fkuhne/ardubot17/Pictures/Photo 25-03-17 10 34 49.jpg

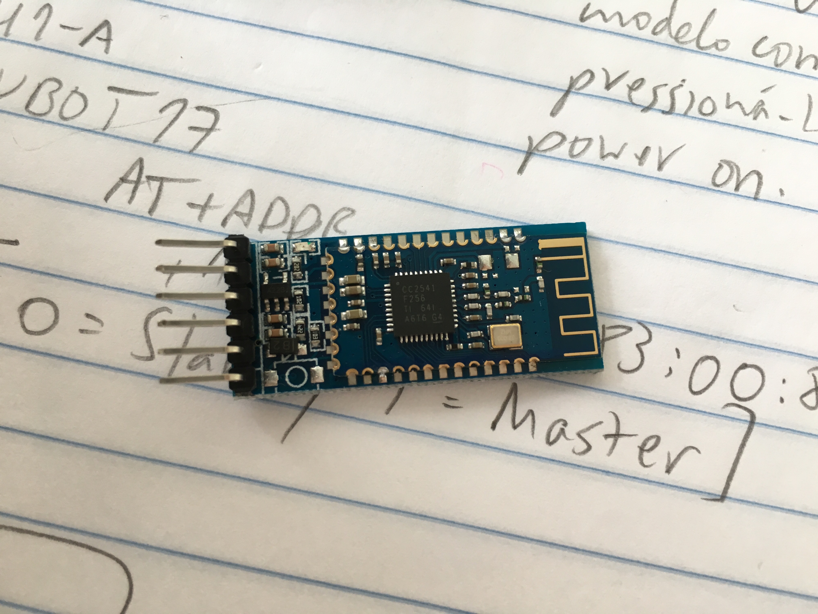
Pictures/Photo 25-03-17 10 34 49.jpg
