fkuhne/ardubot17/README.md

# ardubot17
Development for a remotely controlled toy car (almost a robot, but still not clever enough)
