fkuhne/ardubot17/Apresentação.pptx

## Veículo com controle remoto e Arduinos

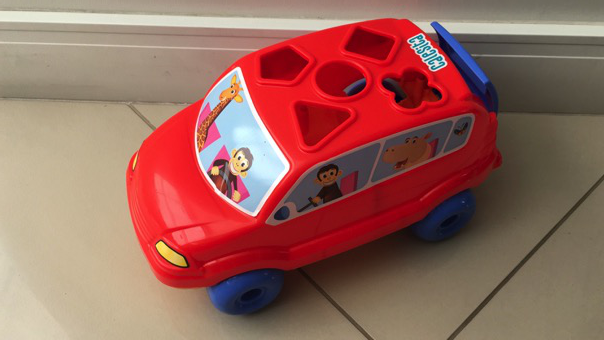
[picture p3: figure]

Felipe Kühne
fkuhne@gmail.com

## Slide 2

Felipe Kühne - fkuhne@gmail.com

github.com/fkuhne/ardubot17

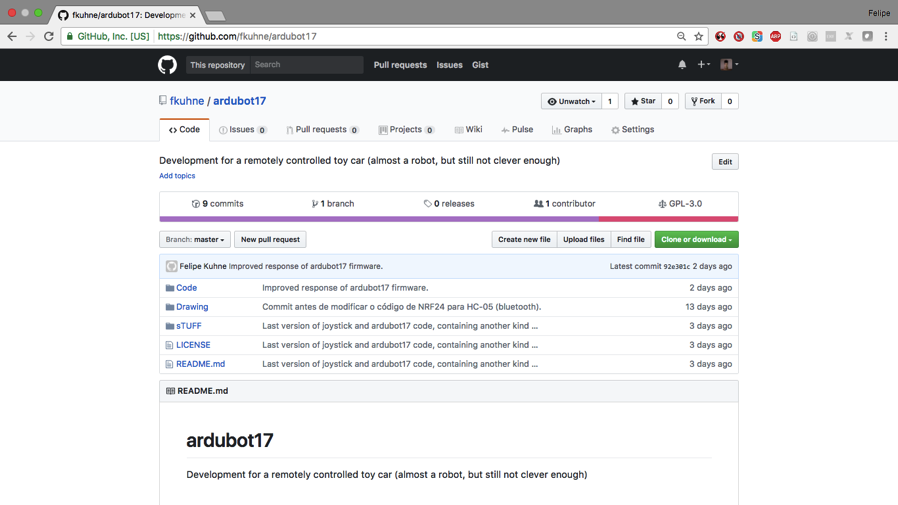
[picture p4: figure]

## Agenda

- Objetivos
- Recursos necessários
- Desenvolvimento
  - Mecânica
  - Eletrônica
  - Software
- O que deu errado (e depois deu certo)
- Trabalhos futuros

## Objetivos

Transformar um brinquedo em um robô móvel

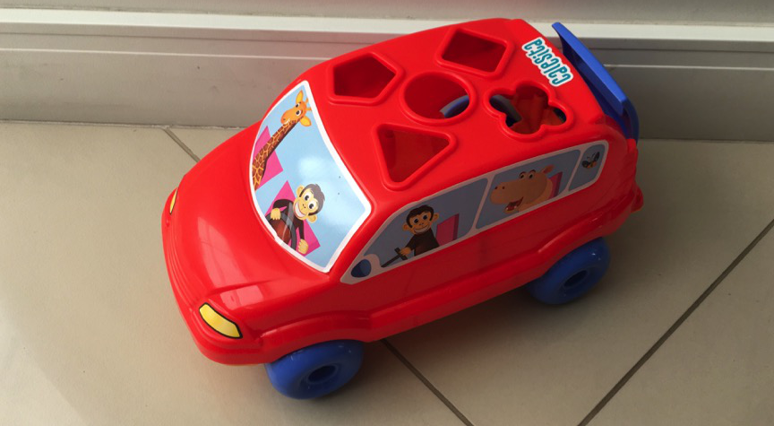
[picture p5: figure]

Não modificar aspectos externos do brinquedo

Ser barato

Poder voltar à sua forma original

Ter baixa complexidade

## Recursos necessários: veículo

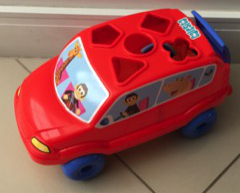
[picture p6: figure]

Carrinho
(R$30)

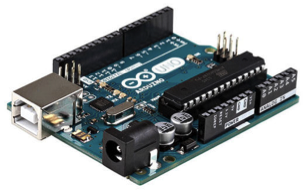
[picture p7: figure]

Arduino Uno
(R$5)

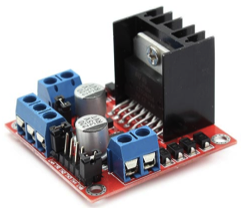
[picture p8: figure]

L298N
(R$6)

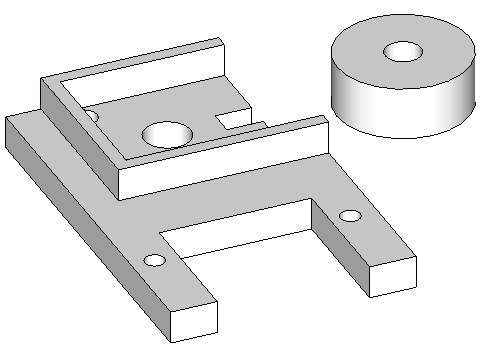
[picture p9: figure]

Suporte para o motor

Módulo Bluetooth
(R$11)

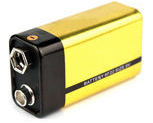
[picture p10: figure]

Bateria (R$20)

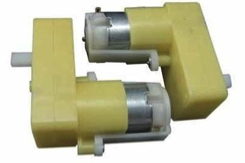
[picture p11: figure]

x2

Motor DC
(R$14)

## Recursos necessários: joystick

Arduino Uno
(R$5)

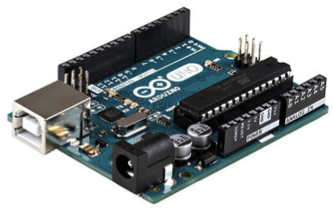
[picture p12: figure]

Protoshield
(R$4)

Módulo Bluetooth HC-05 (R$12)

Bateria (R$20)

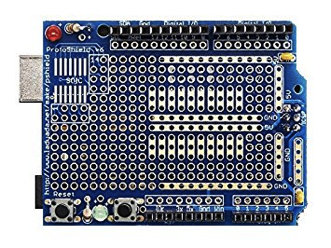
[picture p13: figure]
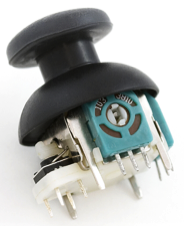
[picture p14: figure]

Joystick
(R$3)

## Recursos necessários: diversos

- Soldador e estanho
- Fitas dupla face
- Balão de festa
- Protoboard
- Parafuso auto-atarrachantes (x8)
- Chave SPST (x2)
- Cabinhos de protoboard (M/M, F/F, M/F)
- Resistores: 2x 1kΩ e 2x 2k2Ω
- Cabos USB
- Multímetro
- Paquímetro
- Ferramentas diversas (alicate, chave de fenda, fita isolante, ...)
- Computador
- Impressora 3D

## Recursos necessários: softwares

- Sketchup (modelagem 3D)
- Arduino IDE (programação do Arduino)
- Autodesk circuits.io (simulação de circuitos e programas online): https://circuits.io/ (https://circuits.io/)

## Desenvolvimento mecânico

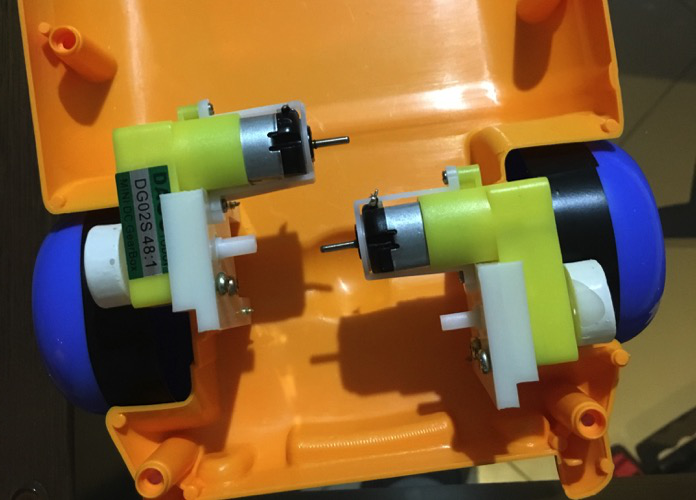
[picture p15: figure]

## Desenvolvimento mecânico

- Modelagem 3D do motor, suporte e rodas de transmissão

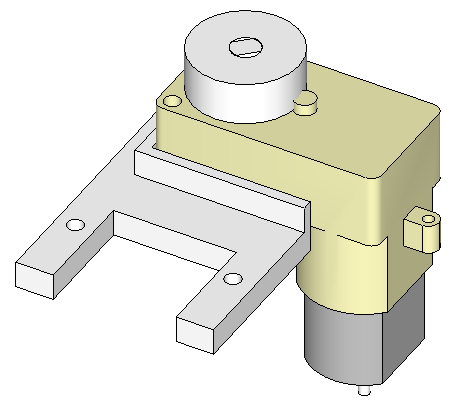
[picture p16: figure]
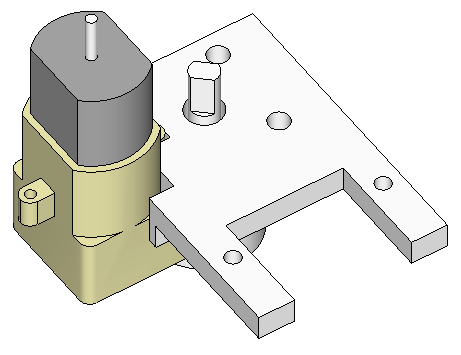
[picture p17: figure]
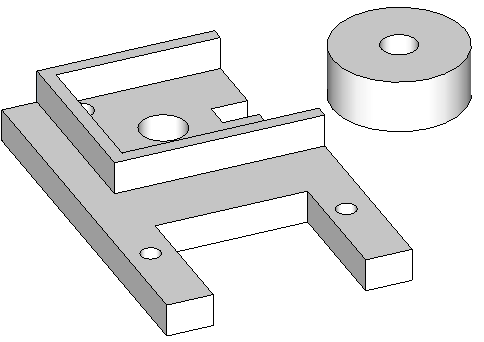
[picture p18: figure]

## Desenvolvimento mecânico

- Fixação dos motores no chassi do carrinho

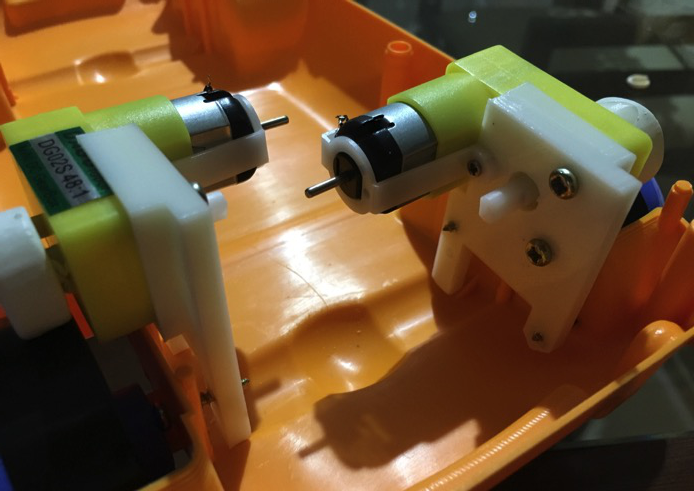
[picture p19: figure]

parafusos
auto-atarrachantes

## Desenvolvimento mecânico

- Fixação dos motores no chassi do carrinho

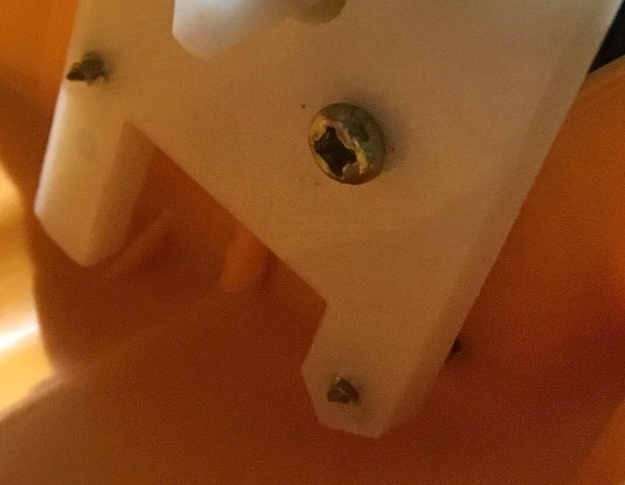
[picture p20: figure]

retrabalho!

## Desenvolvimento mecânico

- Fixação dos motores no chassi do carrinho

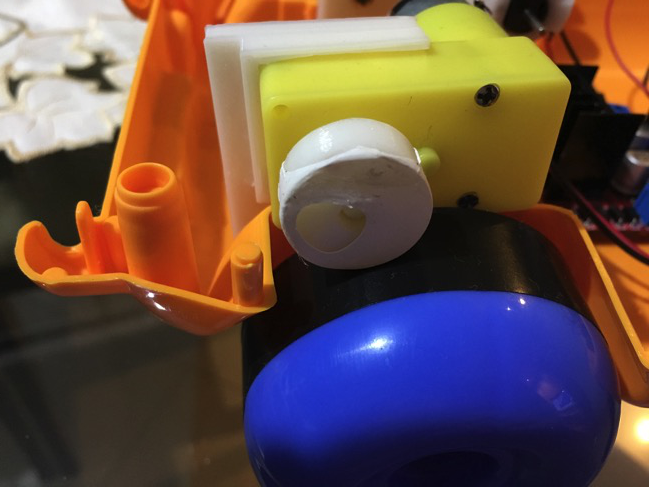
[picture p21: figure]

## Desenvolvimento mecânico

- Fixação dos motores no chassi do carrinho

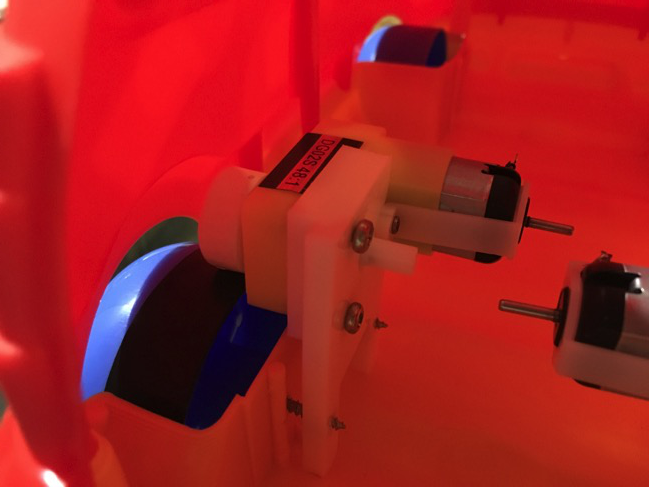
[picture p22: figure]

## Desenvolvimento da eletrônica

- Joystick

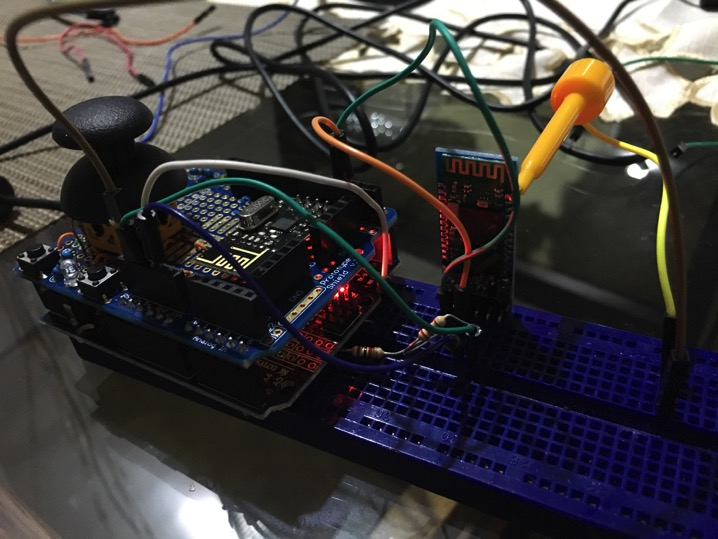
[picture p23: figure]

## Desenvolvimento da eletrônica

- Joystick

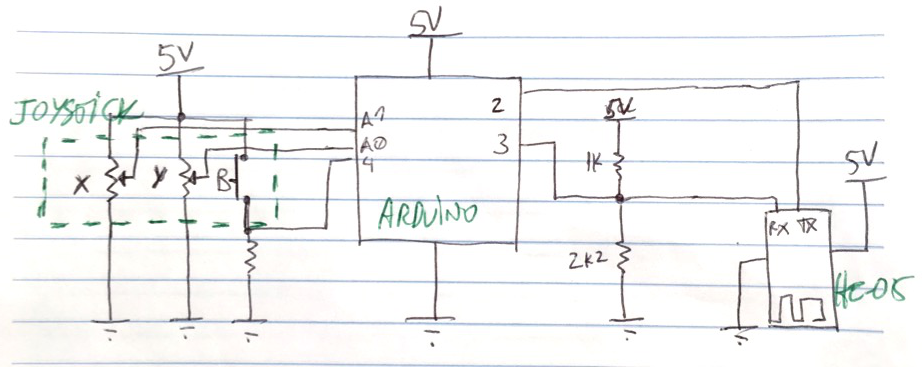
[picture p24: figure]

## Desenvolvimento da eletrônica

- Carrinho

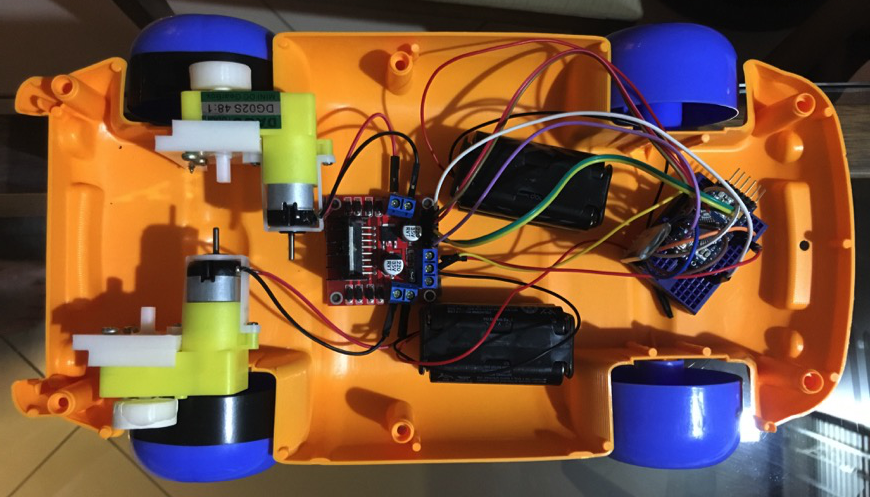
[picture p25: figure]

## Desenvolvimento da eletrônica

- Carrinho

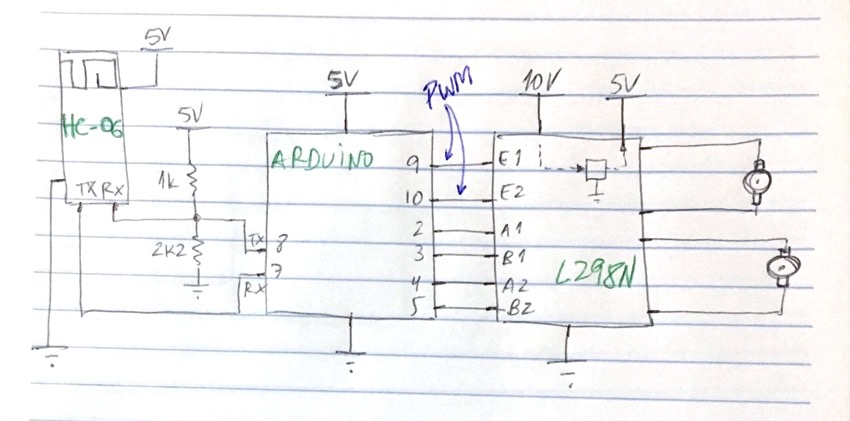
[picture p26: figure]

## Desenvolvimento da eletrônica

- Carrinho – ponte H (L298N)

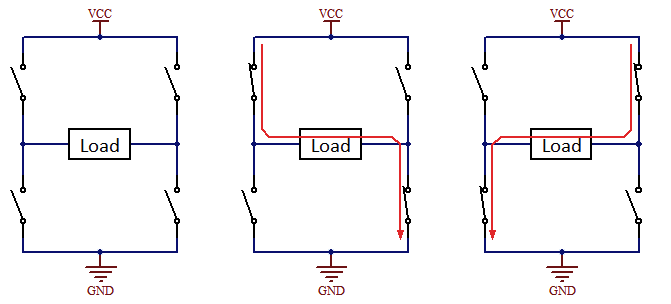
[picture p27: figure]

## Comunicação Bluetooth

HC-05
(MASTER)

HC-06
(SLAVE)

## Comunicação Bluetooth

- Estabelecendo a conexão automática entre o módulo master (HC-05) e o slave (HC-06):
- http://www.martyncurrey.com/connecting-2-arduinos-by-bluetooth-using-a-hc-05-and-a-hc-06-pair-bind-and-link/ (http://www.martyncurrey.com/connecting-2-arduinos-by-bluetooth-using-a-hc-05-and-a-hc-06-pair-bind-and-link/)
- Sigam exatamente os passos descritos acima que vai funcionar! 😬

## Comunicação Bluetooth

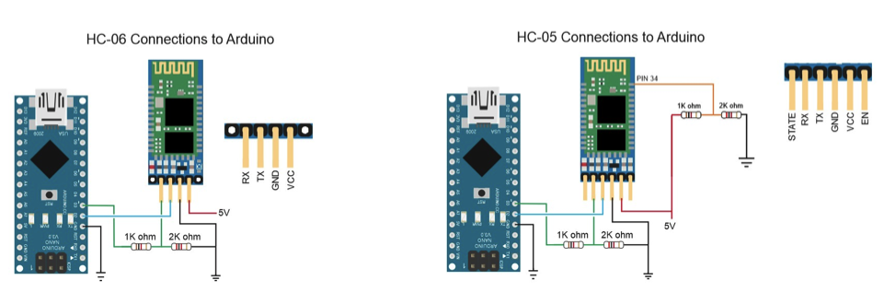
[picture p28: figure]

## Comunicação Bluetooth

- Configurar o HC-06 via comandos AT:
  1. AT+NAMEARDUBOT17
  2. AT+PIN1234
  3. AT+BAUD4 (9600bps)

## Comunicação Bluetooth

- Configurar o HC-05 via comandos AT:
  1. Pressionar o botão e energizar o módulo para entrar em modo AT;
  2. Pino 34 em 3V3;
  3. AT+ORGL (restaurar para as configurações de fábrica)
  4. AT+NAME=JOYSTICK
  5. AT+ROLE=1 (master)
  6. AT+UART=9600,0,0
  7. AT+CMODE=0 (restringe em quem vai conectar)

## Comunicação Bluetooth

- Configurar o HC-05 via comandos AT:
  8. AT+RMAAD (libera pareamentos antigos)
  9. AT+INIT (inicia o perfil SPP)
  10. AT+INQ (pergunta quem está por perto)
  11. AT+RNAME?11,11,210818 (pergunta o nome)
  12. AT+PAIR=11,11,210818 (pareamento)
  13. AT+BIND=11,11,210818 (bind)
  14. AT+CMODE=1
  15. AT+LINK=11,11,210818 (link)

## Desenvolvimento do software

- Consiste em três partes:
1. joystick.ino
2. ardubot17.ino
  - Biblioteca L298N

## Desenvolvimento do software

- joystick.ino – definições e setup

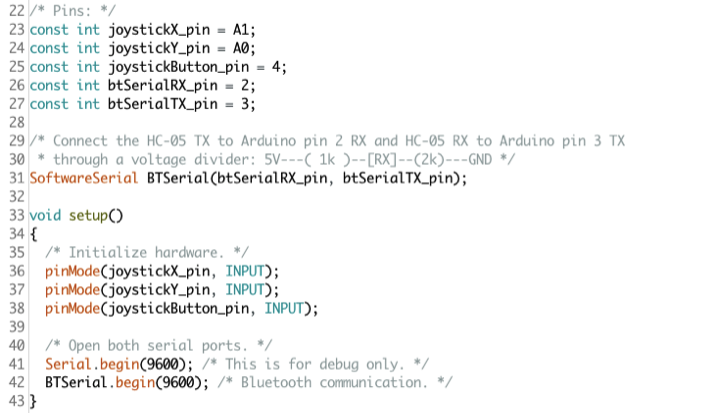
[picture p29: figure]

## Desenvolvimento do software

- joystick.ino - loop

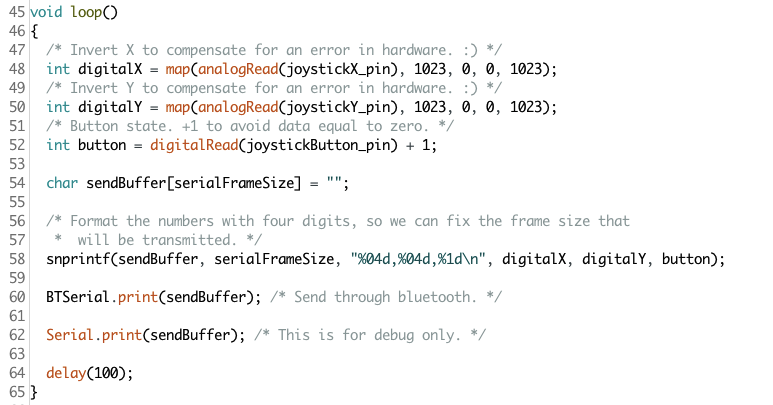
[picture p30: figure]

Ex.:
0763,0012,2\n

## Desenvolvimento do software

- ardubot17.ino - definições

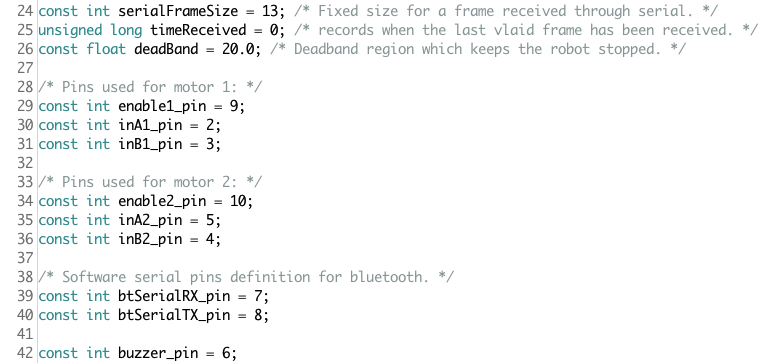
[picture p31: figure]

## Desenvolvimento do software

- ardubot17.ino – definições e setup

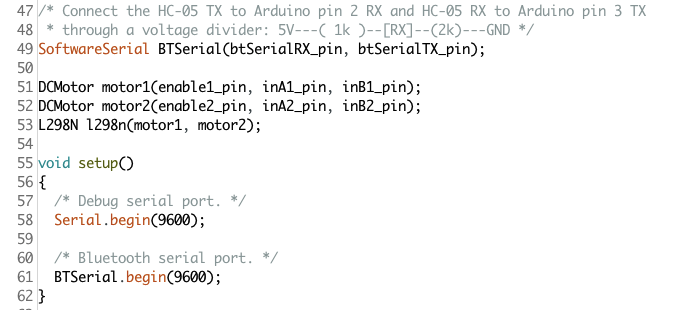
[picture p32: figure]

## Desenvolvimento do software

- ardubot17.ino – loop

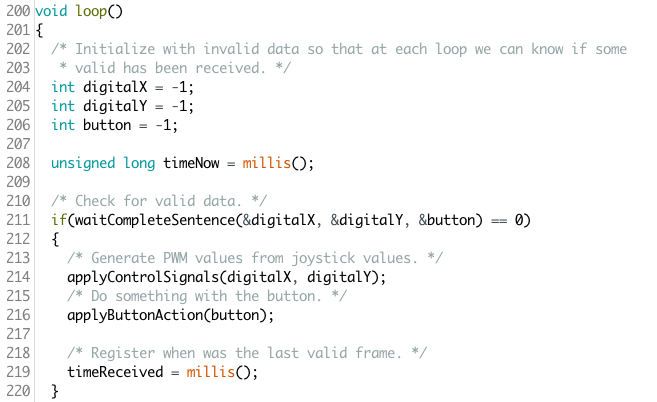
[picture p33: figure]
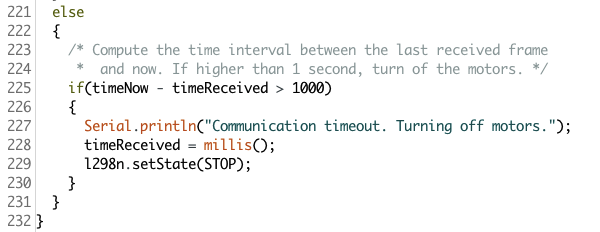
[picture p34: figure]

## Desenvolvimento do software

- ardubot17.ino - parser

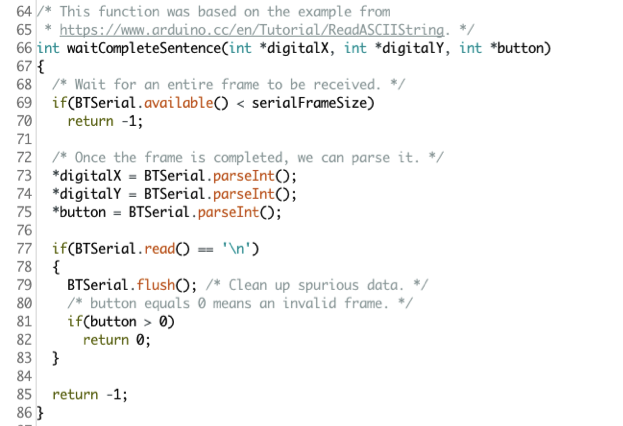
[picture p35: figure]

## Desenvolvimento do software

- ardubot17.ino – calculando o sinal PWM
  - http://electronics.stackexchange.com/questions/19669/algorithm-for-mixing-2-axis-analog-input-to-control-a-differential-motor-drive (http://electronics.stackexchange.com/questions/19669/algorithm-for-mixing-2-axis-analog-input-to-control-a-differential-motor-drive)
  - Mapeamento dos sinais digitais do joystick para sinais de PWM em cada roda
    - Velocidades linear e angular → PWM da roda esquerda e direita

## Desenvolvimento do software

- ardubot17.ino – calculando o sinal PWM 1/3

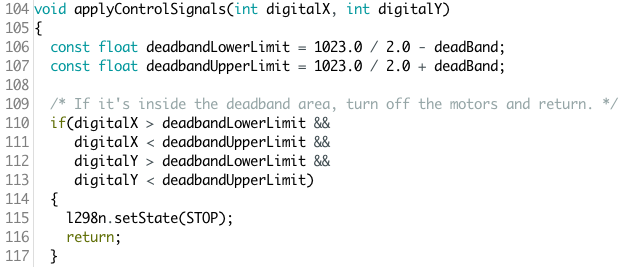
[picture p36: figure]

## Desenvolvimento do software

- ardubot17.ino – calculando o sinal PWM 2/3

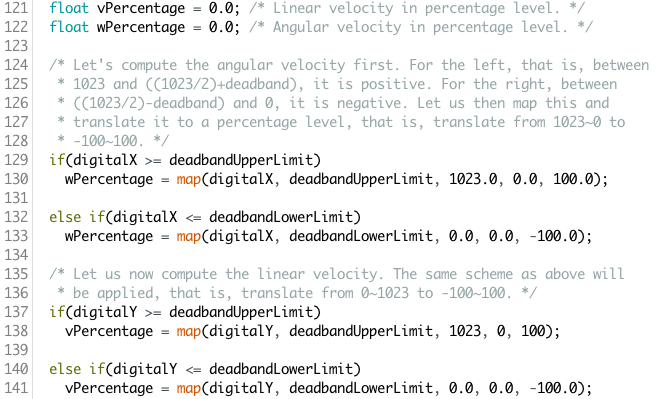
[picture p37: figure]

## Desenvolvimento do software

- ardubot17.ino – calculando o sinal PWM 3/3

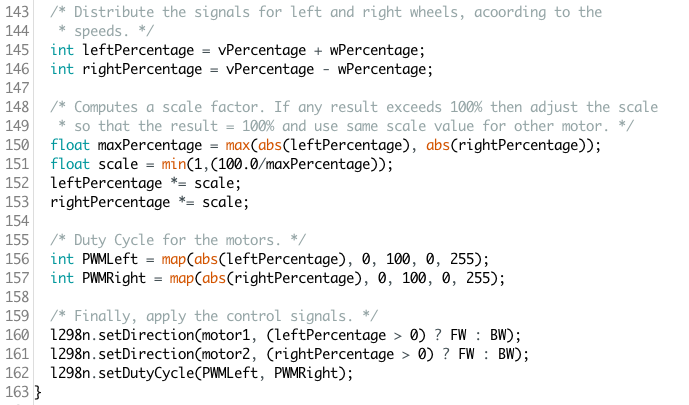
[picture p38: figure]

## O que deu errado (e depois deu certo)

- Rodas de plástico
  - Problemas de aderência
- Relação de redução
  - Ficou muito lento
- Comunicação (NRF24, Zigbee ou BT?)
  - BT: melhor custo/benefício

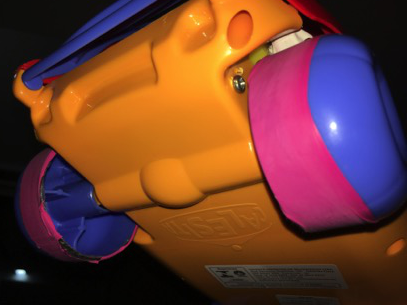
[picture p39: figure]

## O que deu errado (e depois deu certo)

- Configuração cinemática do carrinho
  - Rodas dianteiras com arrasto lateral
  - Acionamento nas 4 rodas (4WD)?

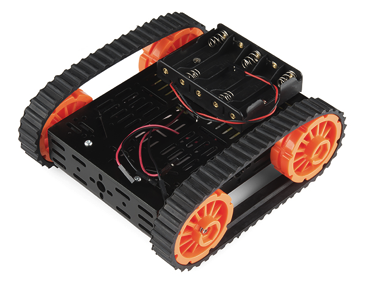
[picture p40: figure]

## O que deu errado (e depois deu certo)

- Configuração cinemática do carrinho
  - Rodas dianteiras com arrasto lateral
  - O ideal é ter duas rodas ativas e uma de apoio

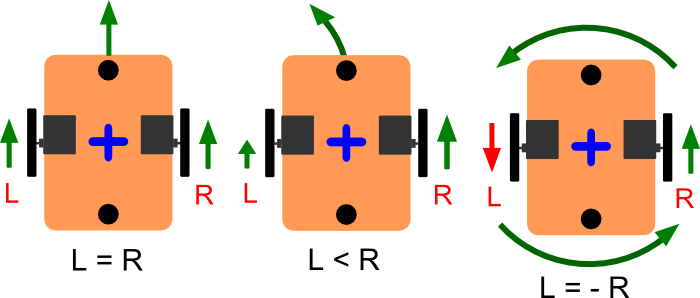
[picture p41: figure]

## O que deu errado (e depois deu certo)

- Configuração cinemática do carrinho
  - Rodas dianteiras com arrasto lateral
  - O ideal é ter duas rodas ativas e uma de apoio
  - Solução:

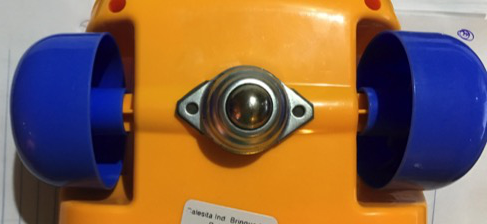
[picture p42: figure]

## Trabalhos futuros

- Utilizar um chassi próprio, com duas rodas ativas e uma de apoio;
- Fazer uma PCI para os circuitos (joystick e carrinho);
- Utilizar joystick do Playstation;
- Adicionar encoders para cálculo de deslocamento;
- Adicionar sensores de proximidade;
- Trocar os motores DC por servomotres MG995.

## Obrigado!

github.com/fkuhne/ardubot17

Felipe Kühne
fkuhne@gmail.com
