fkuhne/ardubot17/Pictures/FullSizeRender.jpg

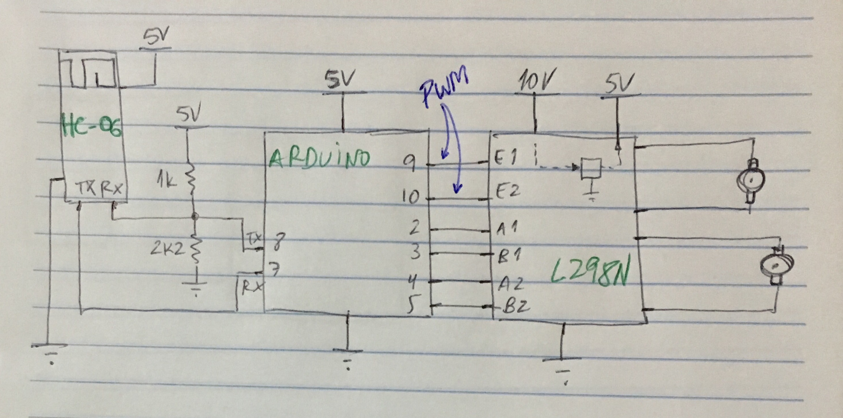
Pictures/FullSizeRender.jpg
