fkuhne/ardubot17/Pictures/IMG_0126.JPG

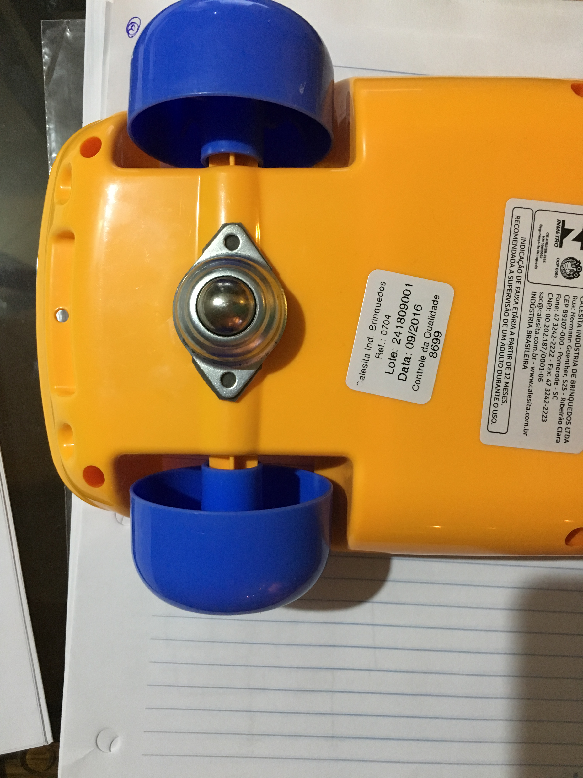
Pictures/IMG_0126.JPG
