fkuhne/ardubot17/Pictures/Photo 11-03-17 17 52 16.jpg

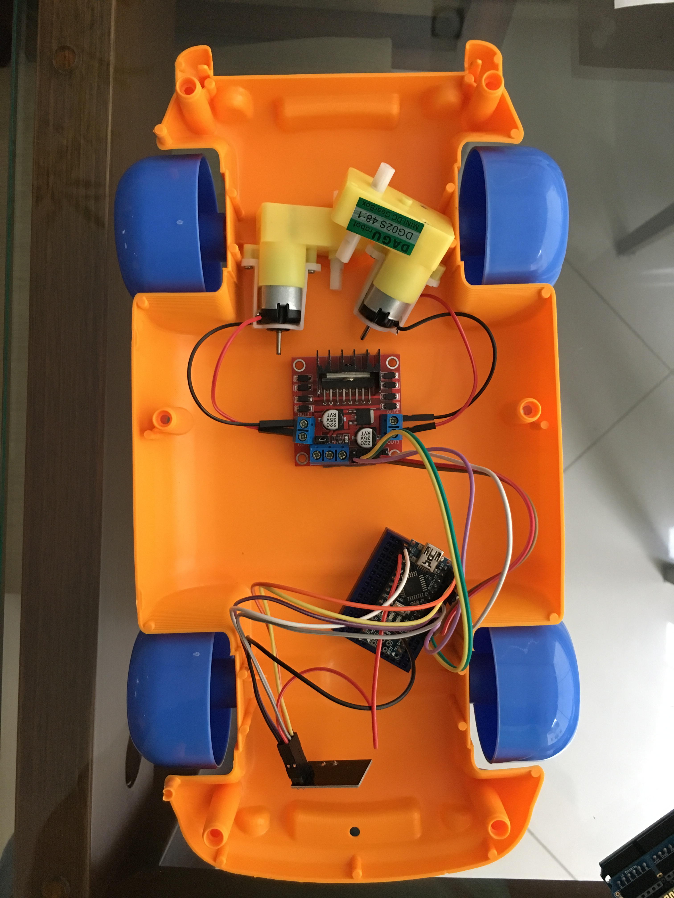
Pictures/Photo 11-03-17 17 52 16.jpg
