fkuhne/ardubot17/Pictures/Photo 11-03-17 17 52 33.jpg

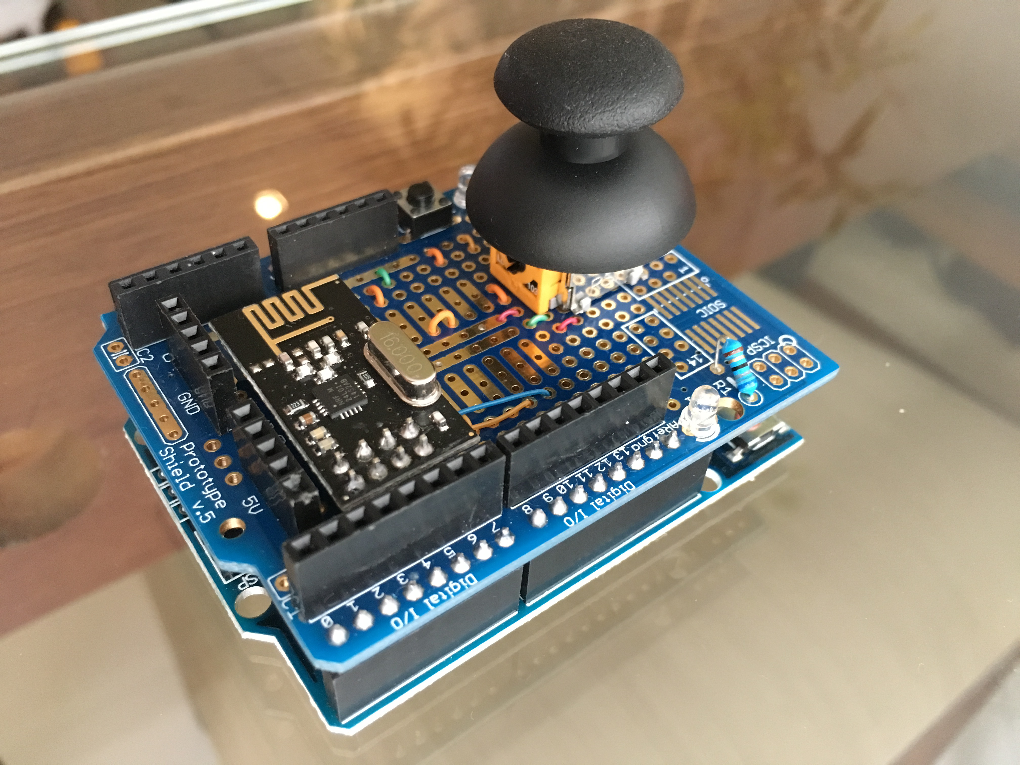
Pictures/Photo 11-03-17 17 52 33.jpg
