fkuhne/ardubot17/Pictures/Photo 17-03-17 23 52 02.jpg

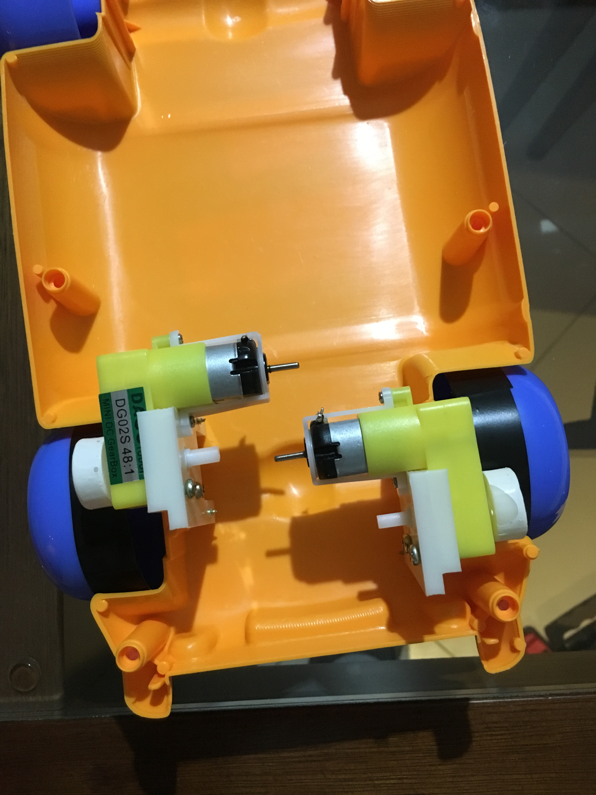
Pictures/Photo 17-03-17 23 52 02.jpg
