fkuhne/ardubot17/Pictures/Photo 17-03-17 23 52 41.jpg

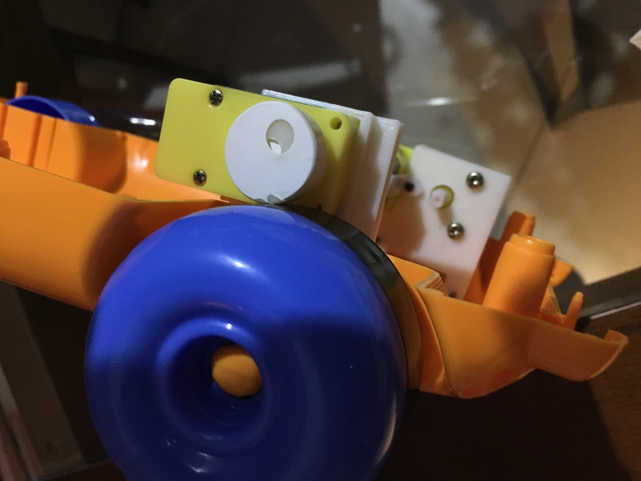
Pictures/Photo 17-03-17 23 52 41.jpg
