fkuhne/ardubot17/Pictures/Photo 17-03-17 23 53 00.jpg

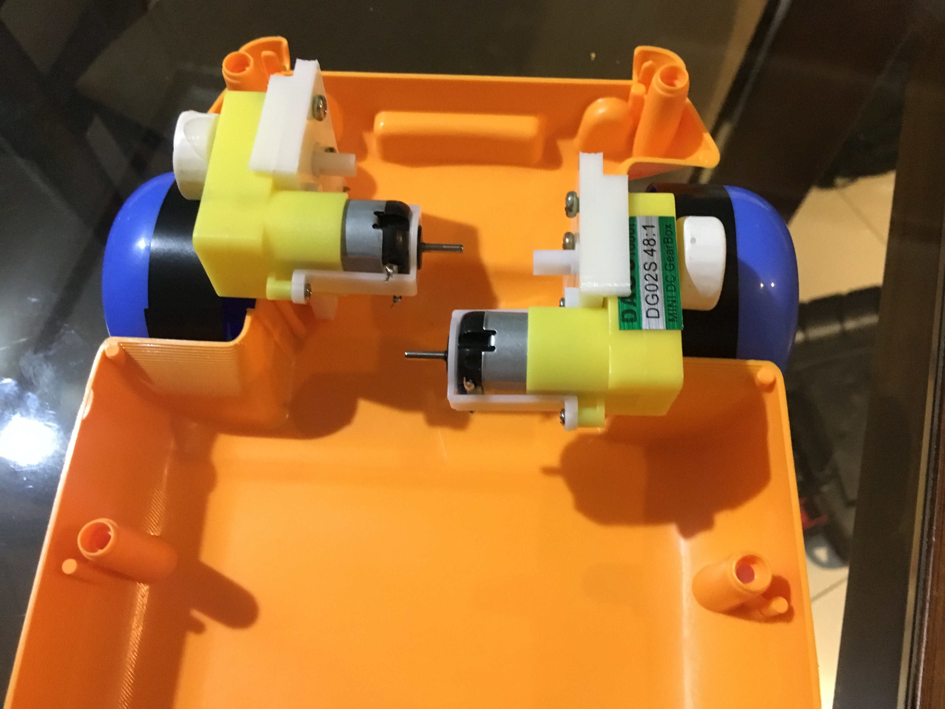
Pictures/Photo 17-03-17 23 53 00.jpg
