fkuhne/ardubot17/Pictures/Photo 26-03-17 11 25 42.jpg

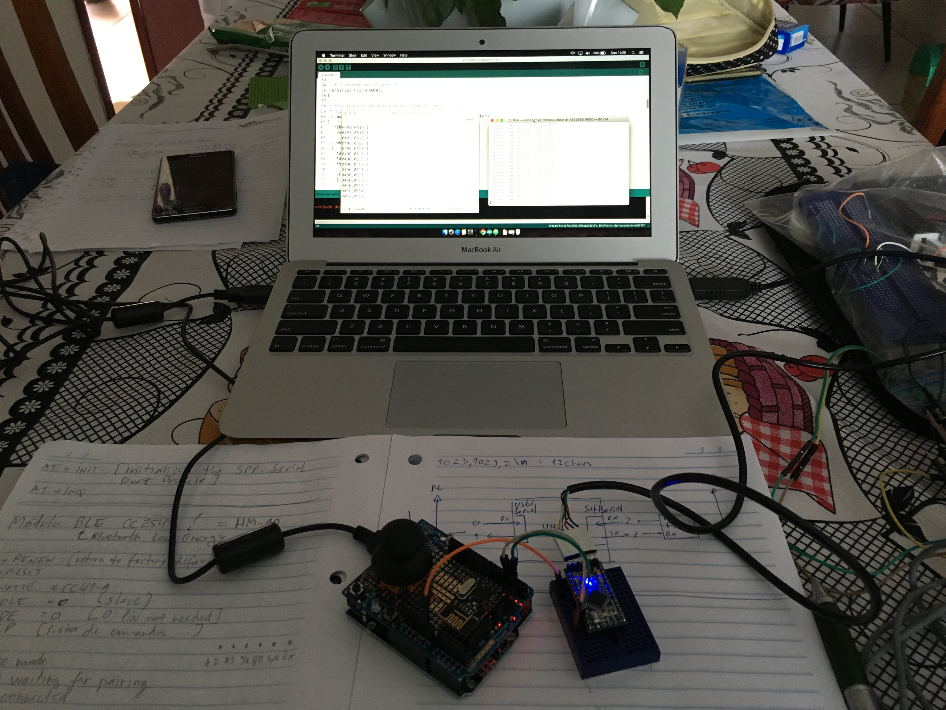
Pictures/Photo 26-03-17 11 25 42.jpg
