fkuhne/ardubot17/Pictures/Photo 28-03-17 01 53 17 (1).jpg

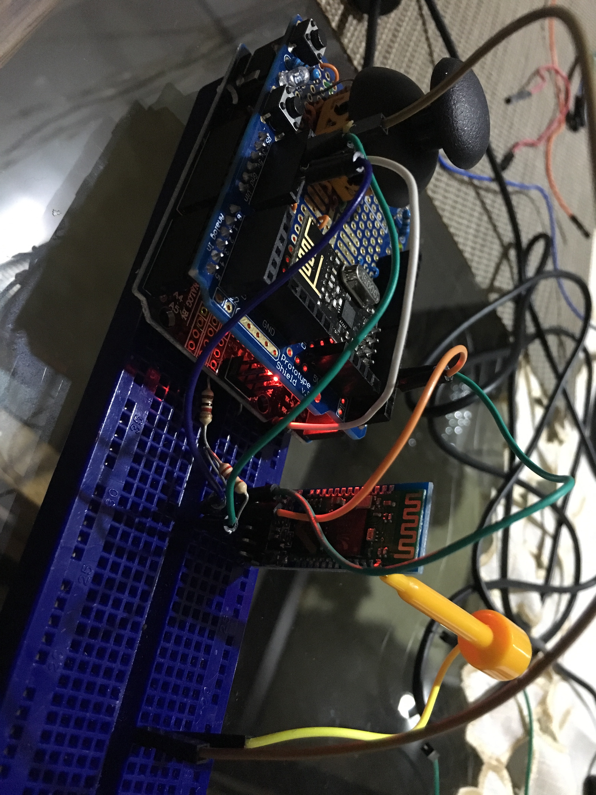
Pictures/Photo 28-03-17 01 53 17 (1).jpg
