fkuhne/ardubot17/Pictures/Photo 28-03-17 01 54 10 (1).jpg

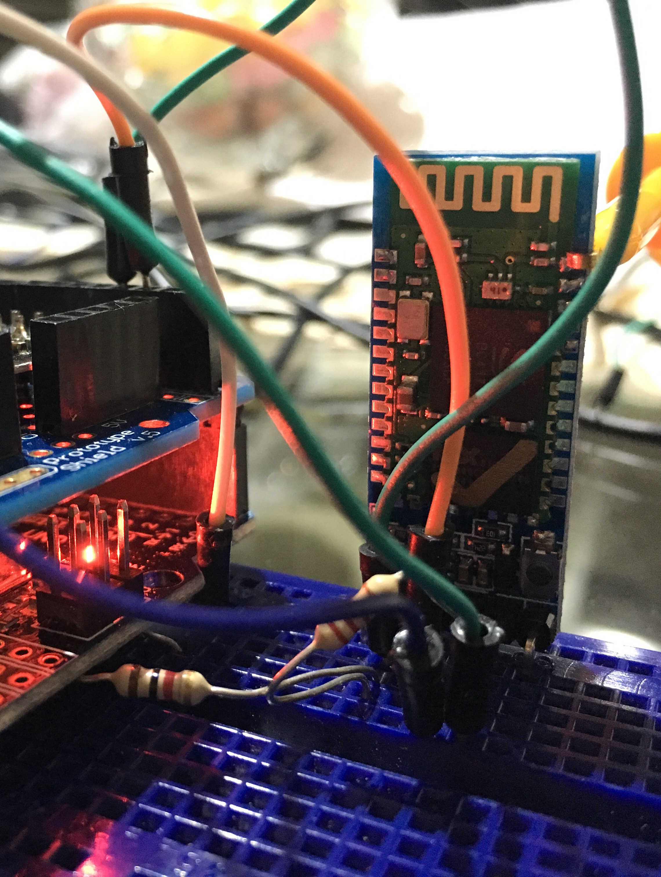
Pictures/Photo 28-03-17 01 54 10 (1).jpg
