fkuhne/ardubot17/Pictures/Photo 28-03-17 23 56 12.jpg

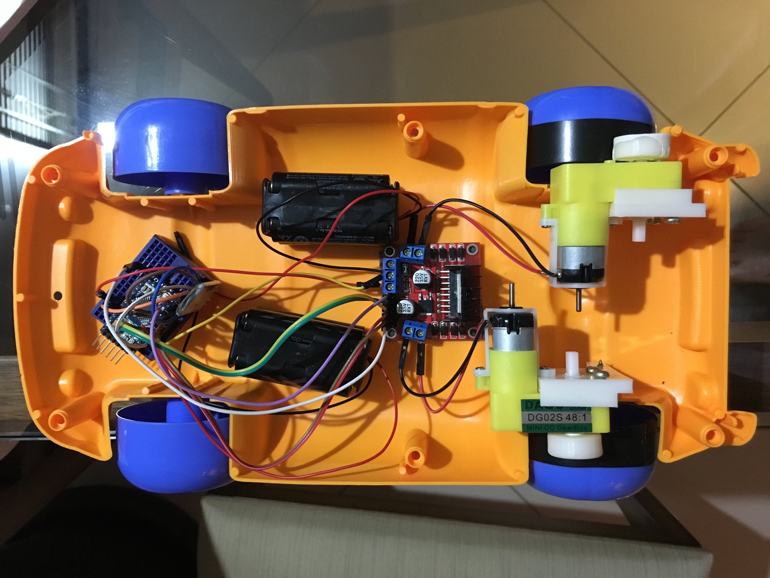
Pictures/Photo 28-03-17 23 56 12.jpg
