fkuhne/ardubot17/Pictures/Photo 29-03-17 00 09 00.jpg

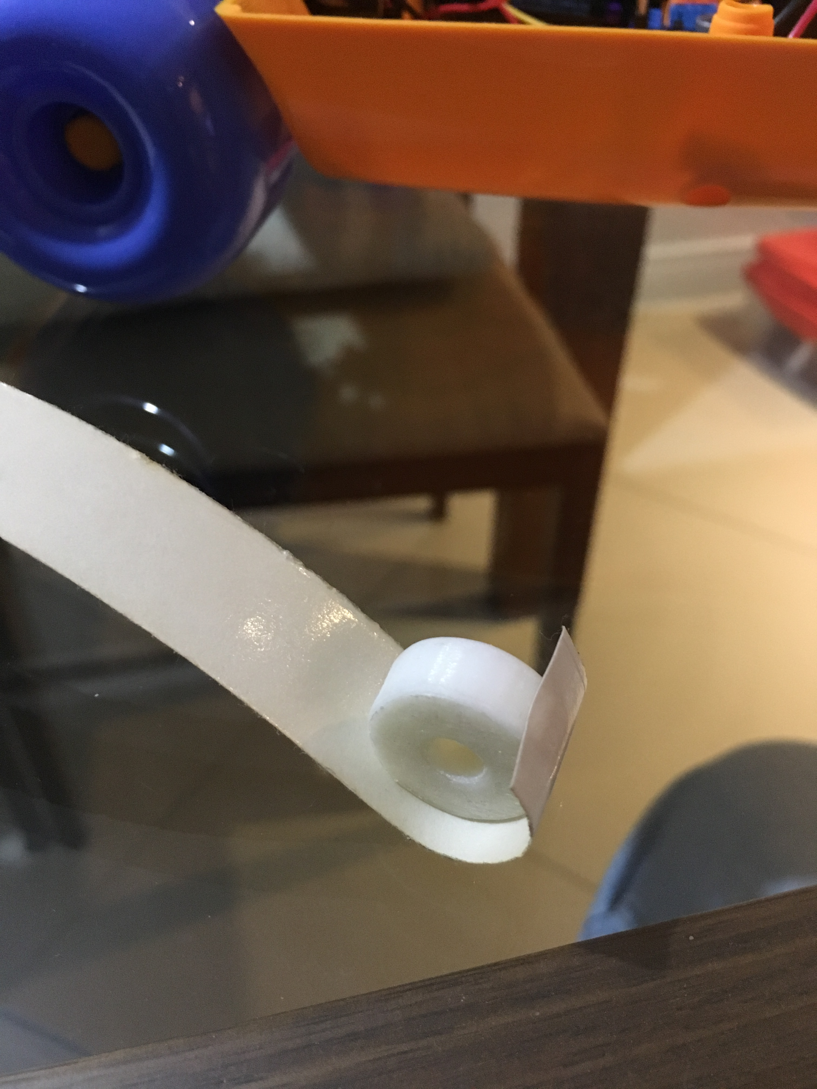
Pictures/Photo 29-03-17 00 09 00.jpg
