fkuhne/ardubot17/Pictures/Screen Shot 2017-03-30 at 01.13.02.png

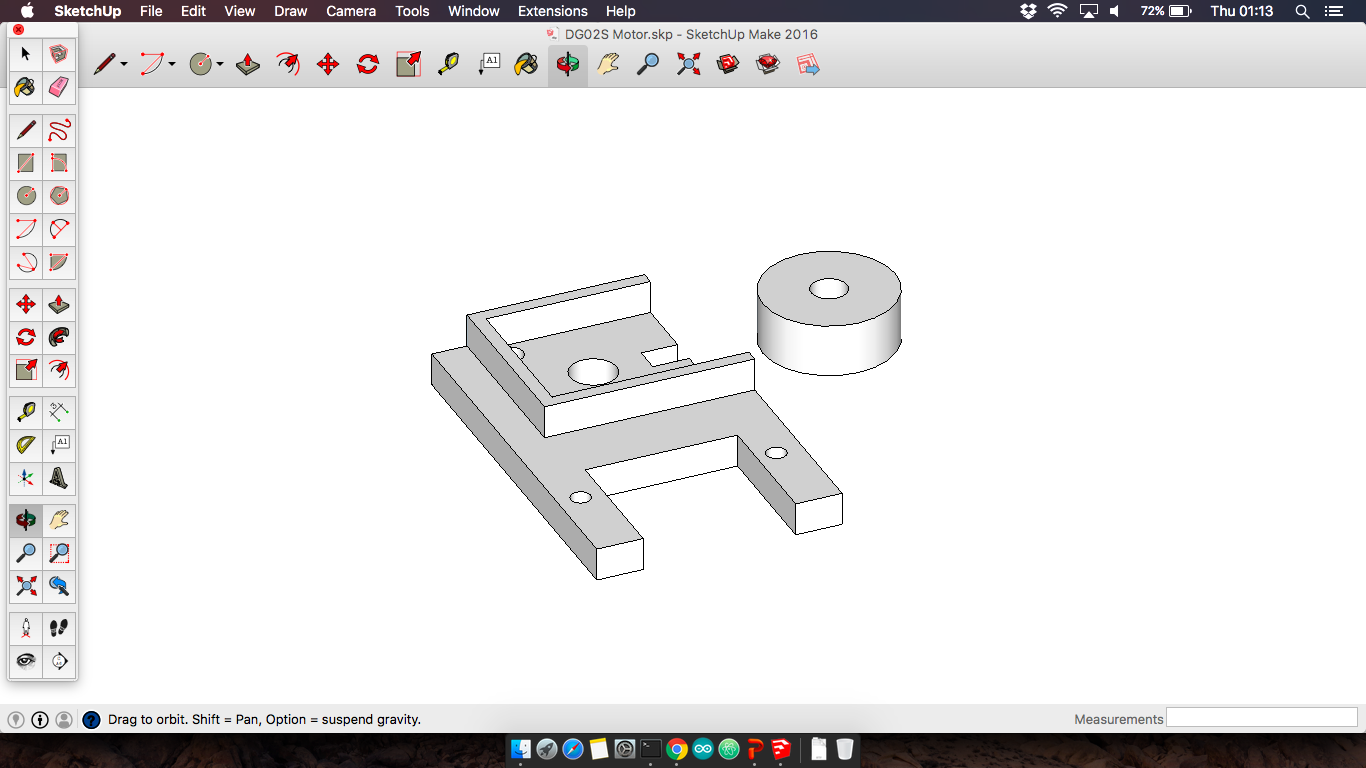
Pictures/Screen Shot 2017-03-30 at 01.13.02.png
