fkuhne/ardubot17/Pictures/Screen Shot 2017-03-31 at 00.08.30.png

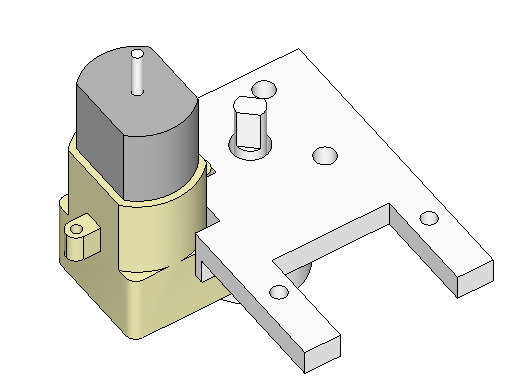
Pictures/Screen Shot 2017-03-31 at 00.08.30.png
