fkuhne/ardubot17/Pictures/Screen Shot 2017-03-31 at 00.09.06.png

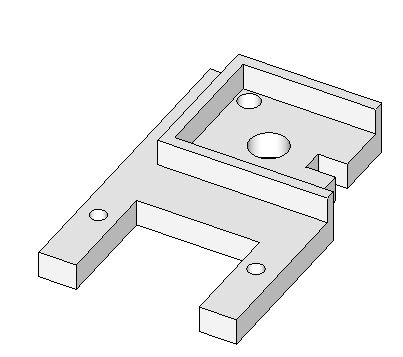
Pictures/Screen Shot 2017-03-31 at 00.09.06.png
