fkuhne/ardubot17/(list of files, cad)

Other CAD files:
Drawing/DG02S Motor.skp
Drawing/Wheel.skp
