fkuhne/ardubot17/(commit log)

2017-03-09 First addition of folders Code (which contains code) and Drawing (which contains drawing).
    [DG02S Motor.skp, Wheel.skp]
2017-03-17 Commit antes de modificar o código de NRF24 para HC-05 (bluetooth).
    [DG02S Motor.skp]
2017-03-27 Last version of joystick and ardubot17 code, containing another kind of serial parsing, which worked better in this case.
